Zurcaf/011-ELECTRONICS_petBionics/hardware/pcb/kicad/PetBionic_PCB.step

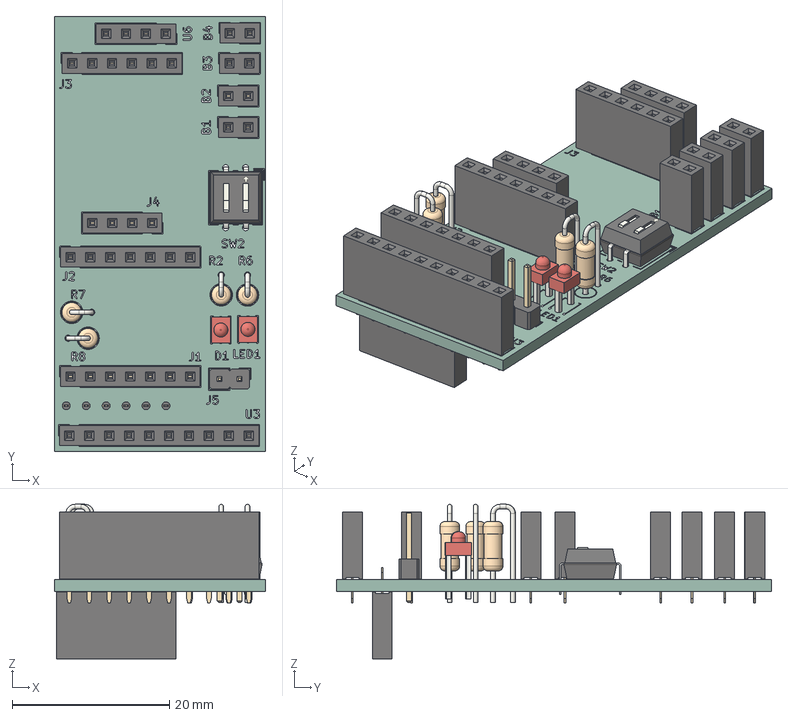
[picture p1: CAD file, 2026-03-02]
hardware/pcb/kicad/PetBionic_PCB.step
26.9 x 55.4 x 19.7 mm
PinSocket_1x06_P2.54mm_Vertical x 2
PinSocket_1x07_P2.54mm_Vertical x 2
R_Axial_DIN0207_L6.3mm_D2.5mm_P2.54mm_Vertical x 4
PinHeader_1x02_P2.54mm_Vertical
PinSocket_1x02_P2.54mm_Vertical x 4
LED_D1.8mm_W3.3mm_H2.4mm x 2
SW_DIP_SPSTx02_Slide_6.7x6.64mm_W7.62mm_P2.54mm_LowProfile
PinSocket_1x10_P2.54mm_Vertical
PinSocket_1x04_P2.54mm_Vertical x 2
PetBionic_PCB_silkscreen x 2
PetBionic_PCB_PCB
