Zurcaf/011-ELECTRONICS_petBionics/hardware/pcb/kicad/PetBionic_PCB.kicad_pcb

## KiCad design hardware/pcb/kicad/PetBionic_PCB.kicad_pcb (2026-03-02)

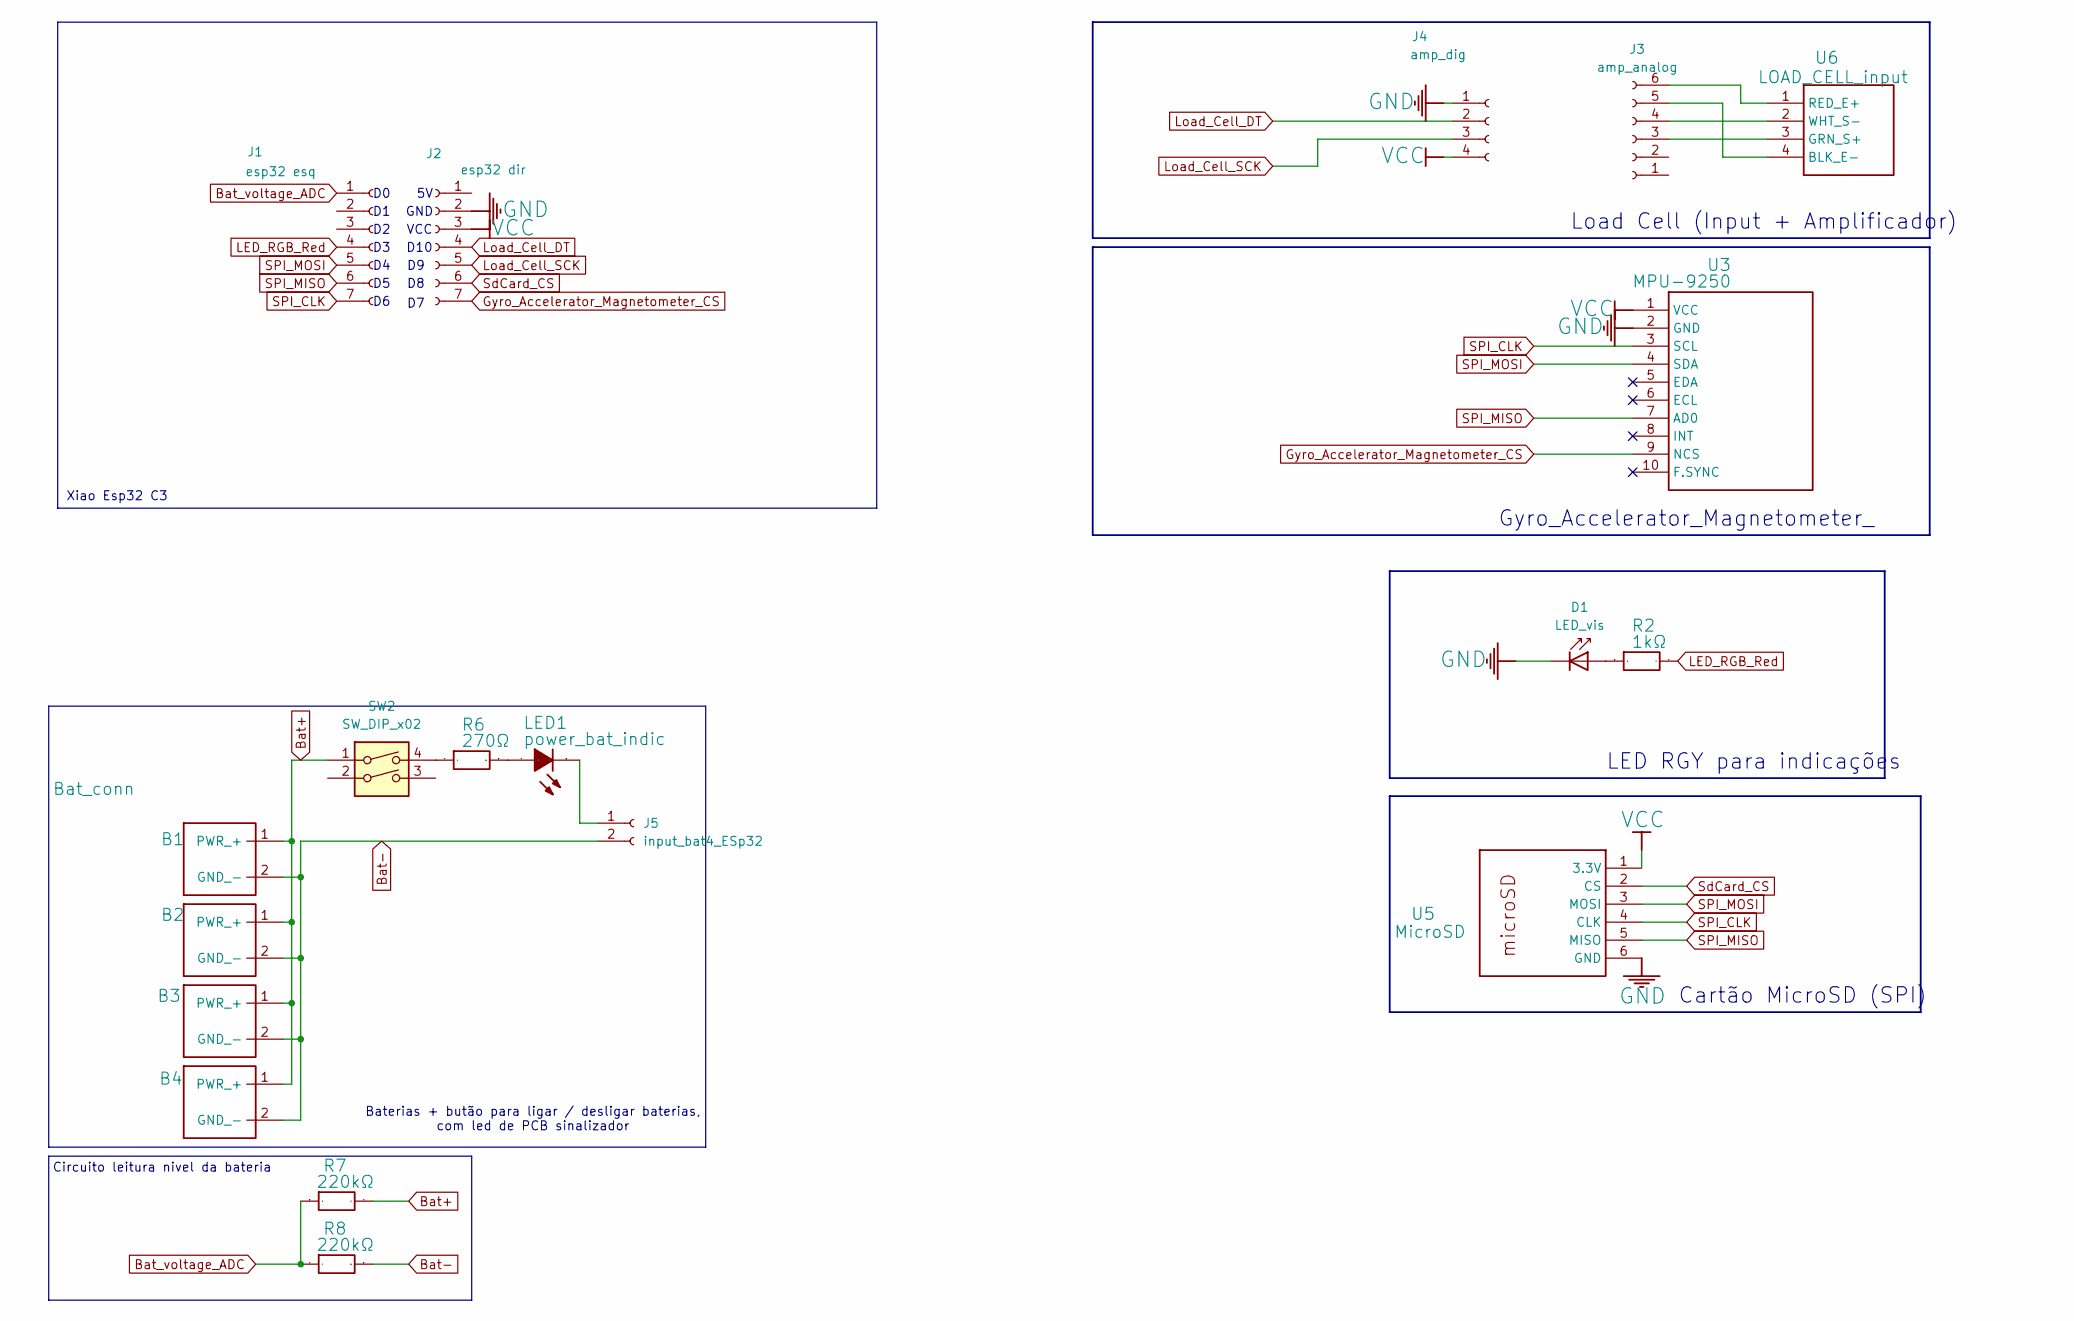
[picture p2: schematic PetBionic_PCB.kicad_sch]

Parts:
B1, B2, B3, B4: Bat_conn; PinSocket_1x02_P2.54mm_Vertical
D1: LED_vis; LED_D1.8mm_W3.3mm_H2.4mm
J1: esp32 esq; PinSocket_1x07_P2.54mm_Vertical
J2: esp32 dir; PinSocket_1x07_P2.54mm_Vertical
J3: amp_analog; PinSocket_1x06_P2.54mm_Vertical
J4: amp_dig; PinSocket_1x04_P2.54mm_Vertical
J5: input_bat4_ESp32; PinHeader_1x02_P2.54mm_Vertical
LED1: power_bat_indic; LED_D1.8mm_W3.3mm_H2.4mm; Manufacturer Part LED-0603
R2: 1kΩ; R_Axial_DIN0207_L6.3mm_D2.5mm_P2.54mm_Vertical; Manufacturer Part PTFR0603Q1K00N9
R6: 270Ω; R_Axial_DIN0207_L6.3mm_D2.5mm_P2.54mm_Vertical; Manufacturer Part SCR0603F270R
R7, R8: 220kΩ; R_Axial_DIN0207_L6.3mm_D2.5mm_P2.54mm_Vertical; Manufacturer Part FRR0603F2203TS
SW2: SW_DIP_x02; SW_DIP_SPSTx02_Slide_6.7x6.64mm_W7.62mm_P2.54mm_LowProfile
U3: MPU-9250; PinSocket_1x10_P2.54mm_Vertical
U5: MicroSD; PinSocket_1x06_P2.54mm_Vertical; Manufacturer Part Micro SD TF
U6: LOAD_CELL_input; PinSocket_1x04_P2.54mm_Vertical

Connections:
Bat+: B1.1 (PWR_+), B2.1 (PWR_+), B3.1 (PWR_+), B4.1 (PWR_+), R7.2, SW2.1
Bat-: B1.2 (GND_-), B2.2 (GND_-), B3.2 (GND_-), B4.2 (GND_-), J5.2, R8.1
Bat_voltage_ADC: J1.1, R7.1, R8.2
GND: D1.1 (K), J2.2, J4.1, U3.2 (GND), U5.6 (GND)
Gyro_Accelerator_Magnetometer_CS: J2.7, U3.9 (NCS)
LED_RGB_Red: J1.4, R2.2
Load_Cell_DT: J2.4, J4.2
Load_Cell_SCK: J2.5, J4.3
unnamed: D1.2 (A), R2.1
unnamed: J3.3, U6.3 (GRN_S+)
unnamed: J3.4, U6.2 (WHT_S-)
unnamed: J3.5, U6.4 (BLK_E-)
unnamed: J3.6, U6.1 (RED_E+)
unnamed: J5.1, LED1.1 (-)
unnamed: LED1.2 (+), R6.1
unnamed: R6.2, SW2.4
SPI_CLK: J1.7, U3.3 (SCL), U5.4 (CLK)
SPI_MISO: J1.6, U3.7 (AD0), U5.5 (MISO)
SPI_MOSI: J1.5, U3.4 (SDA), U5.3 (MOSI)
SdCard_CS: J2.6, U5.2 (CS)
VCC: J2.3, J4.4, U3.1 (VCC), U5.1 (3.3V)

Notes on the sheet:
Cartão MicroSD (SPI)
D10
Load Cell (Input + Amplificador)
Gyro_Accelerator_Magnetometer_
Circuito leitura nivel da bateria
VCC
Baterias + butão para ligar / desligar baterias, com led de PCB sinalizador
Xiao Esp32 C3
GND
LED RGY para indicações

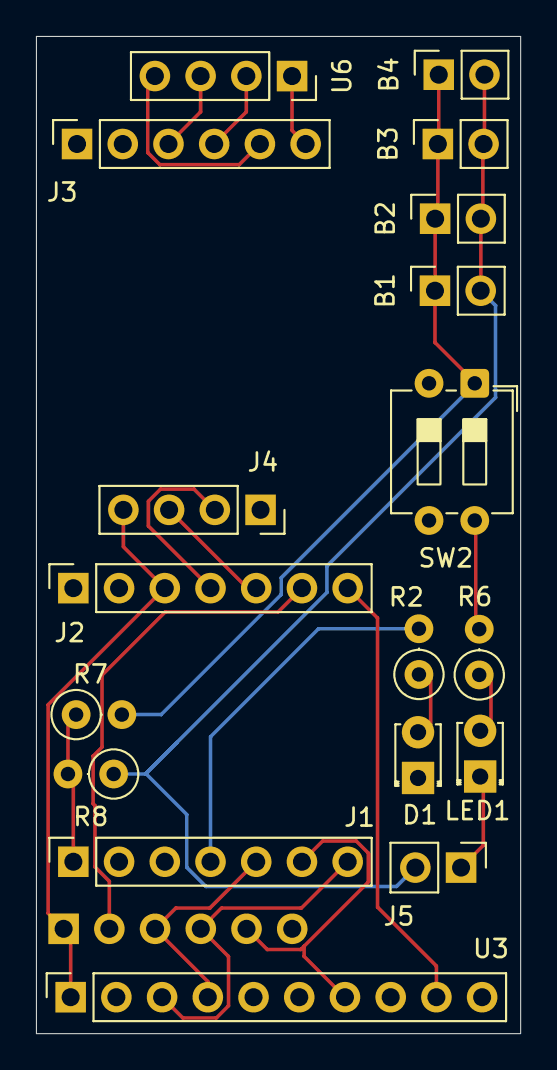
[picture p3: board PetBionic_PCB.kicad_pcb from above]

Board: 2 copper layers, 26.9 x 55.4 mm, 19 parts (1 on the bottom side), 21 nets.
