Zurcaf/011-ELECTRONICS_petBionics/firmware/arduino-experiments/sensors/teste_led/teste_led.ino

#define RED   3   // D1
#define GREEN 4   // D2
#define BLUE  5   // D3 (your "yellow")

void setup() {
  pinMode(RED, OUTPUT);
  pinMode(GREEN, OUTPUT);
  pinMode(BLUE, OUTPUT);
}

void loop() {
  // RED
  digitalWrite(RED, HIGH);
  digitalWrite(GREEN, LOW);
  digitalWrite(BLUE, LOW);
  delay(1000);

  // GREEN
  digitalWrite(RED, LOW);
  digitalWrite(GREEN, HIGH);
  digitalWrite(BLUE, LOW);
  delay(1000);

  // BLUE
  digitalWrite(RED, LOW);
  digitalWrite(GREEN, LOW);
  digitalWrite(BLUE, HIGH);
  delay(1000);
}
