Zurcaf/011-ELECTRONICS_petBionics/(commit log)

2026-03-02 PCB V1 feita e encomendada
    [PetBionic_PCB.kicad_pcb, PetBionic_PCB.kicad_sch, PetBionic_PCB.step, bom.csv, designators.csv, positions.csv]
2026-03-22 chore: reorganize repo structure and add cross-platform git hygiene
    [PetBionic_PCB.kicad_pcb, PetBionic_PCB.kicad_sch, PetBionic_PCB.step, bom.csv, designators.csv, positions.csv]
2026-04-03 BLE connecta e reconneccta tranquilo agr (corrigido esse bug
    state da app estava mal agr está bom e corrigido
    [BleControl.cpp]
2026-04-03 SdCard IMU e HX711 estão com status bom e time sink talvez
2026-04-03 feat: align BLE/app protocol and add session-based IMU logging
    - align Android status UI and automatic time sync retry behavior
    - update BLE commands for PERIOD/RATE and apply system clock sync
    - switch pipeline timing to fixed microsecond schedule (80 Hz default)
    - add magnetometer fields (mx,my,mz) to sensor pipeline and CSV output
    - implement per-session SD logging with day/run file naming
    - add IMU orientation hardware test (roll/pitch/yaw)
    - refresh project README documentation to match current behavior
    [AppConfig.h, BleControl.cpp, PetBionicsApp.cpp, PetBionicsApp.h, RawSdLogger.cpp, RawSdLogger.h]
2026-04-03 docs: consolidate architecture, app and hardware readmes
    - rewrite root README to reflect current system behavior
    - add central docs hub under docs/README.md
    - add Android app README with structure and BLE contract summary
    - add hardware README with PCB structure, pinout and integration flow
2026-04-03 Fix BLE status/clock sync and stabilize logging pipeline
    [BleControl.cpp, BleControl.h, PetBionicsApp.cpp, RawSdLogger.cpp, RawSensor.cpp, RawSensor.h]
2026-04-03 Fix firmware time sync, SD session numbering, and sensor status stability
    [BleControl.cpp, PetBionicsApp.cpp, RawSdLogger.cpp, RawSensor.cpp]
2026-04-04 feat: atualizar app e firmware com melhorias de BLE e orientação
2026-04-06 Enable Firestore sync: per-reading PATCH with API key auth
    - Reactivate WiFi/Firestore in PetBionicsApp (was commented out)
    - Replace batchWrite (403 — requires OAuth2) with individual PATCH per
    reading (works with API key, same as session doc)
    - BLE deinit before sync to free ~60 KB heap for TLS handshake;
    bleRestartNeeded flag triggers BLE restart after sync completes
    - Switch to huge_app partition (3 MB) to fit BLE + WiFi + TLS + SD
    - Remove NimBLE from lib_deps (firmware uses ESP32 BLE Arduino built-in)
    - Disable PETBIONICS_BLE_DEBUG for production build
    [AppConfig.h, FirestoreSync.cpp, FirestoreSync.h, PetBionicsApp.cpp]
2026-05-11 Update Android launcher assets and align IMU load test pinout
2026-05-11 Reorganize legacy docs and Arduino IDE archive folders
